joseluu/POWER-METER-HP33330B-M5STACK/README.md

# POWER-METER-HP33330B-M5STACK
This is a instrument to mesure RF power , using a M5Stack and a HP33330B probe
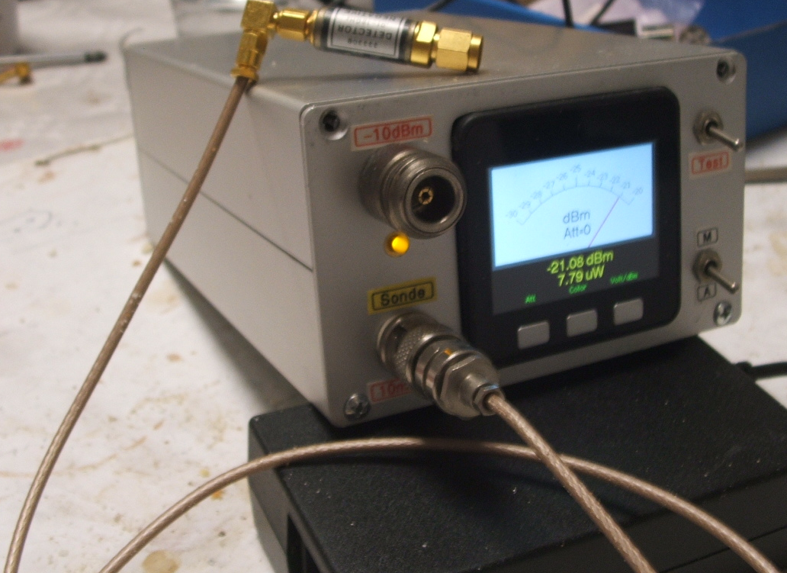
[picture p1: photos/M5_build_F1GE.png]
Photo de la version de F1GE

It can also be build for smaller ESP32 devkits by Heltec
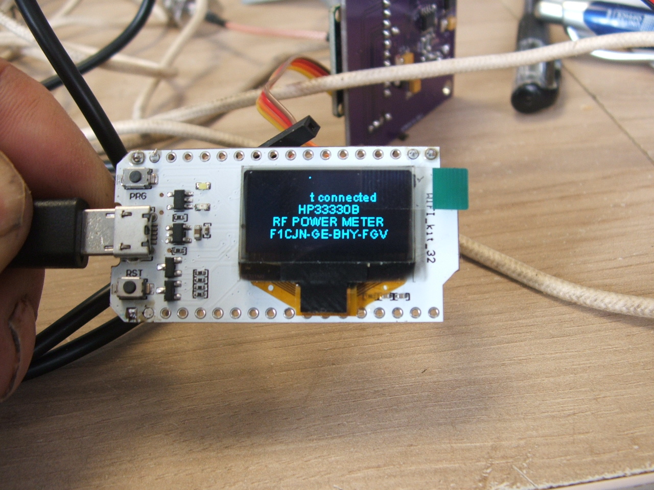
[picture p2: photos/V2_text_F1GE.JPG]
V2 board

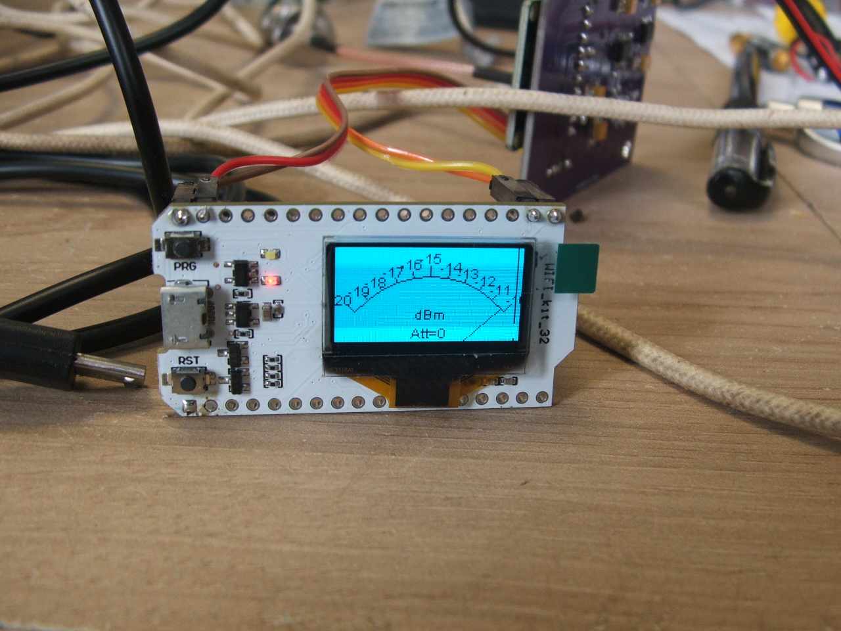
[picture p3: photos/V2_operation_F1GE.JPG]
V2 board in operation

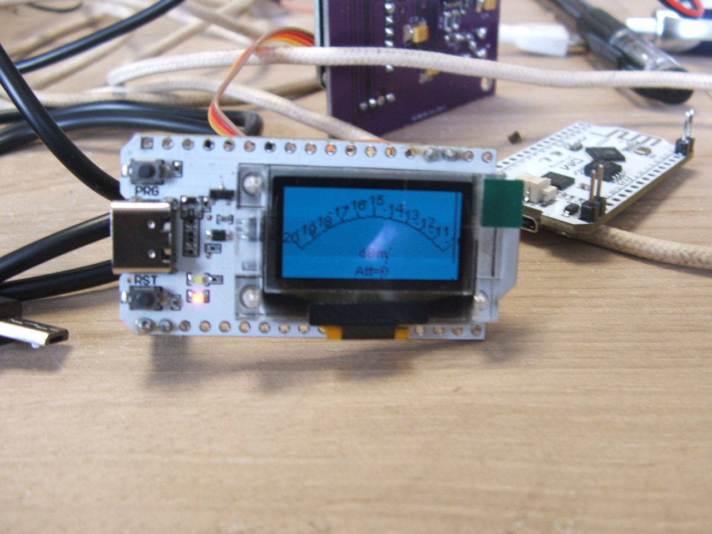
[picture p4: photos/V3_operation_F1GE.JPG]
V3 board in operation
