joseluu/POWER-METER-HP33330B-M5STACK/docs/Power Meter HP33330B_gb.pdf

,

alain.fort.f1cjn at gmail.com January 2023

The assembly includes a very low offset operational amplification mounted as a -2 gain amplifier. The output voltage of the amplifier is between 0 and 4 volts, which allows accurate measurement in the range between -30dBm and +20dBm, a range which can be extended with an input attenuator.

RF power meter using HP33330B probe

The voltage measurement is performed by an A/D converter from Texs Instruments ADS1115 which allows 32768 different measurement values in the range 0 to 4.095 Volt. The value of the low weight is of the order of 0.150 mV.

This digital power meter uses a diode detector probe from Hewlett Packard type HP33330B. This probe has a negative voltage output.

F1GE and F1BHY

Information processing and display are carried out by an M5Stack Core (see image). Warning: do not take the M5Stack Core2 which does not have buttons.

The advantage of using this probe is that the level measured is very precise and almost independent of the input frequency up to 22 GHz, which is not the case with commercial integrated circuits. The probe is given for +-0.3dB up to 12.5GHz and +- 0.6dB beyond.

by F1CJN

This probe is available from Marcel F1GE f1ge.mg@gmail.com

Machine Translated by Google http://docs.m5stack.com/en/quick_start/m5core/arduino

Make sure everything is in place.

Operation When
powered up, if the electronic assembly is not powered or present, the M5Stack displays “ADS1115 “not connected”.

Left button: it allows to compensate the reading when an attenuator is mounted upstream of the probe (from 0 to 40 dB) which allows a maximum of reading 100 mW full scale with 0 dB of attenuation and 1kW (60dBm) full scale with 40dB of attenuation. Attenuation is displayed behind the needle

The selected mode is memorized and active on the next power-up.

In tools, you must choose the M5Stack-Core-ESP32 card to load
the libraries if you have never loaded them - ADS1115_WE - M5Stack -EEProm

Central button: allows you to choose different colors for text display.

Right button: It is used to read the voltage measured at the output of the OPA192 amplifier, i.e. twice the actual voltage at the terminals of the probe. The voltage is around 0mV with no input signal and around 4096 at full scale.

Between -10dBm and +15dBm 'linear' zone the calculation is performed by linear interpolation from point measurements every 5dB. The voltage is that measured at the output of the amplifier, available by pressing the button on the right.

Note: the program was calibrated with an HP 8648C generator and at a frequency of 100 MHz using a representative probe.
Between -30dBm and -10 dBm the calculation (quadratic curve) is made from the HP documentation.

If you calibrate your diode, the values are to be entered in the lines in lines 55 to 61

A second press on the key returns to dBm/mW.

Software: the program compiles with the Arduino IDE V1 or V2.03. Check during use that you have loaded the libraries, in particular M5stack and ADS1115_WE.

For Arduino novices follow the procedure described here

OP)Ex@

I

YOU"

EFuW

x

P_N

FILE NAME:

AND

4

«)P1

AND

19:12:00

EFuW

PAGE:

A
D

A

P_N

DATE:

4

/

AND

eh

P_N

TIME:

ON»

1AV

I

IN_

T

F1CJN

«ON6S_'@

@

_«‘D//F

/

eh

1AV)

4

P_N

BY:

EFuW

@

EFuW

D

«onecturgPORT)ggMAstackg«oreg,notg«oreg@+

1AV

T

)»SEEEA

@

'IN

PATH:

I

AND

I

4

EFuW

IF

DESIGN TITLE: Wattmetre HP33330B

ÿN«

V1

DT'FA

@

DTFA

IN_

I

«)P6

/

Schema_HP33330B_V2.DSN
10/01/2023

'D

Wow

"Yes

DA

IN@

R@

"AND

RE

70mA with M5stack Core

R4

ADS1115

UE

'/

U4

«4

1AV

«A

»4 1N4001

«@

Road

'AND

'@ | '4 | will | 'A

Monday

3

F | J

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
1 of 1

J

C | H

5

6

8

9

A | G | K

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
A | K

REV: 1.0
