joseluu/POWER-METER-HP33330B-M5STACK/docs/Schema_HP33330B_V2.PDF

+5V

D3 1N4001

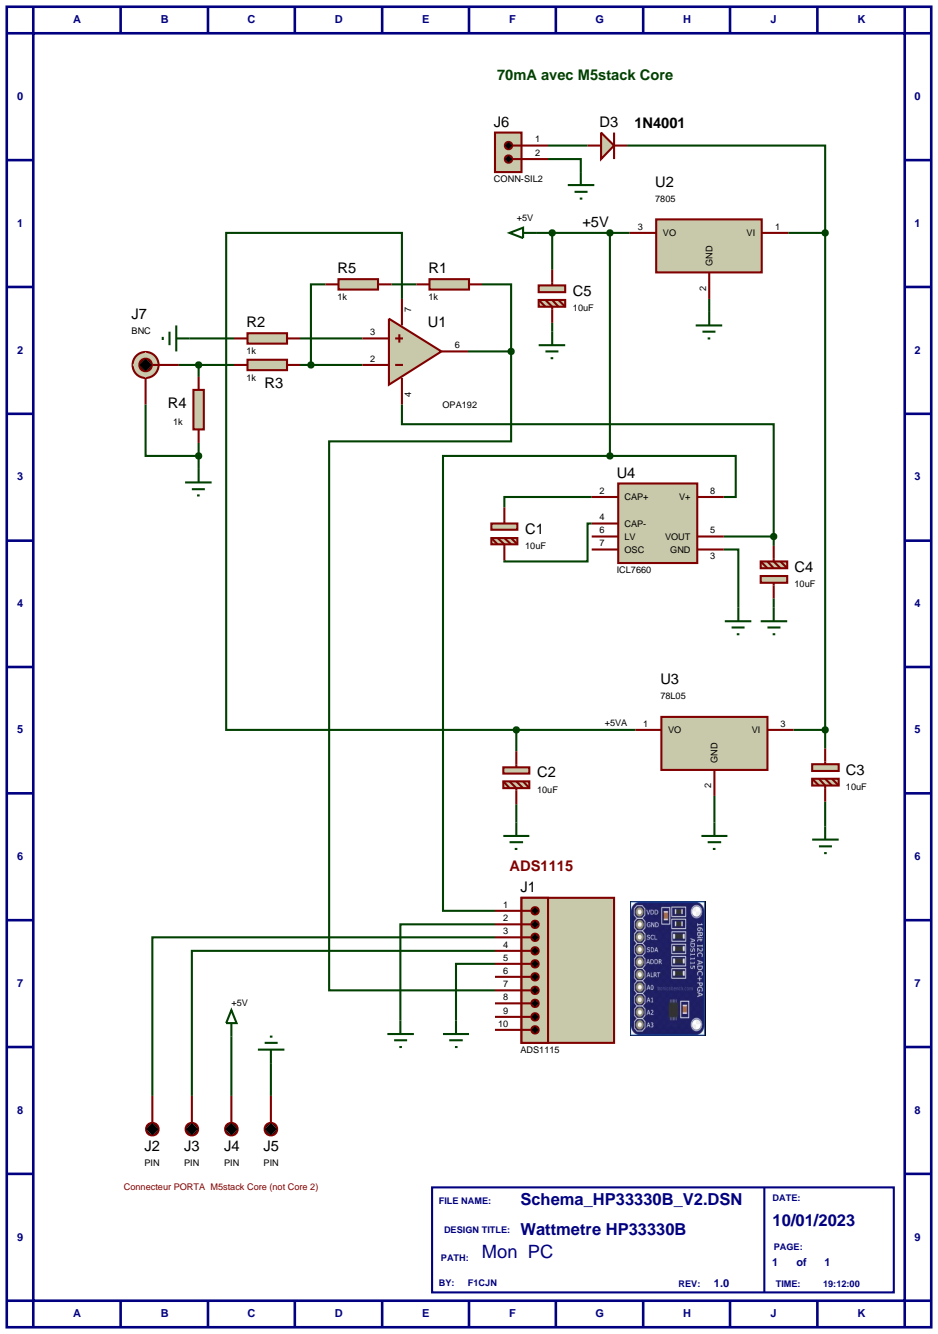
[picture p7: page 1]

Connecteur PORTA M5stack Core (not Core 2)
