joseluu/POWER-METER-HP33330B-M5STACK/(commit log)

2023-02-28 V9 de F1CJN
2023-02-28 adaptated to ESP32-DevKit with 0.85 oled BW display
2023-03-01 moving the arduino file in its own sub directory
2023-03-11 add button fonctionality
